Supra-J/Phased-Antenna-Array/(commit log)

2026-09-04 Add files via upload
    Wilkinson combiner schematic
    [power combiner.sch]
2026-09-04 Add files via upload
    Antenna array model
2026-09-04 Add files via upload
    Touchstone file containing S-parameters for antenna array.
